Dynacore-dev/PoolGuard/hardware/PoolDosingController/PoolDosingController.png

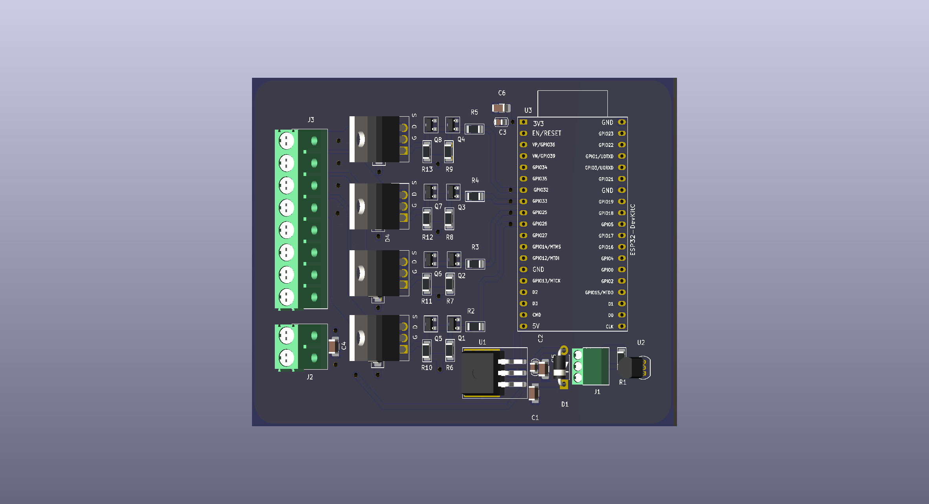
hardware/PoolDosingController/PoolDosingController.png
