Dynacore-dev/PoolGuard/hardware/PoolDosingController/PoolDosingController2.png

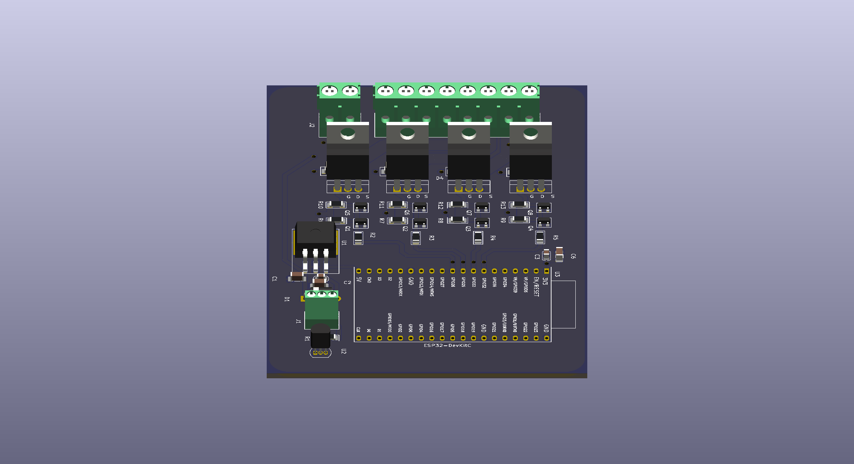
hardware/PoolDosingController/PoolDosingController2.png
