Dynacore-dev/PoolGuard/hardware/PoolDosingController/PoolDosingController-BOM.csv

# | References | Qty | Value | Footprint | MPN | DNP
1 | C1 | 1 | 0.33uF | Capacitor_SMD:C_1206_3216Metric_Pad1.33x1.80mm_HandSolder
2 | C2, C3 | 2 | 0.1uF | PCM_Capacitor_SMD_AKL:C_0805_2012Metric
3 | C4, C5, C6 | 3 | 10uF | Capacitor_SMD:C_1206_3216Metric_Pad1.33x1.80mm_HandSolder
4 | D1 | 1 | 1N4001 | PCM_Diode_THT_AKL:D_DO-41_SOD81_P7.62mm_Horizontal
5 | D2, D3, D4, D5 | 4 | SS16 | Diode_SMD:D_SMA
6 | J1 | 1 | Screw_Terminal_01x03 | TerminalBlock:TerminalBlock_Xinya_XY308-2.54-3P_1x03_P2.54mm_Horizontal
7 | J2 | 1 | Screw_Terminal_2_P5.00mm | TerminalBlock_Phoenix:TerminalBlock_Phoenix_PT-1,5-2-5.0-H_1x02_P5.00mm_Horizontal
8 | J3 | 1 | Screw_Terminal_4_P5.00mm | TerminalBlock_Phoenix:TerminalBlock_Phoenix_PT-1,5-8-5.0-H_1x08_P5.00mm_Horizontal
9 | Q1, Q2, Q3, Q4, Q5, Q6, Q7, Q8 | 8 | MMBT3904 | PCM_Package_TO_SOT_SMD_AKL:SOT-23
10 | Q9, Q10, Q11, Q12 | 4 | IRFZ44N | PCM_Package_TO_SOT_THT_AKL:TO-220-3_Vertical_GDS
11 | R1 | 1 | 2.2K | PCM_Resistor_SMD_AKL:R_1206_3216Metric_Pad1.42x1.75mm_HandSolder
12 | R2, R3, R4, R5 | 4 | 220 | PCM_Resistor_SMD_AKL:R_1206_3216Metric_Pad1.42x1.75mm_HandSolder
13 | R6, R7, R8, R9, R10, R11, R12, R13 | 8 | 10K | PCM_Resistor_SMD_AKL:R_1206_3216Metric_Pad1.42x1.75mm_HandSolder
14 | U1 | 1 | LM7805S | PCM_Package_TO_SOT_SMD_AKL:TO-263-3_TabPin2 | L7805ABD2T-TR
15 | U2 | 1 | DS18S20 | Package_TO_SOT_THT:TO-92_Inline | DS18S20+
16 | U3 | 1 | ESP32-DevKitC | PCM_Espressif:ESP32-DevKitC | ESP32-DEVKITC-32E
