Dynacore-dev/PoolGuard/hardware/Dosieranlage/Dosieranlage.csv

# | Reference | Qty | Value | Footprint | DNP
1 | C1 | 1 | 0,33uF | Capacitor_SMD:C_1206_3216Metric_Pad1.33x1.80mm_HandSolder
2 | C2 | 1 | 0,1uF | Capacitor_SMD:C_0805_2012Metric_Pad1.18x1.45mm_HandSolder
3 | D1 | 1 | 1N4001 | Diode_SMD:D_SOD-123F
4 | D2, D3, D4, D5 | 4 | SS16 | Diode_SMD:D_SMA_Handsoldering
5 | J1 | 1 | JST_05 | Connector_JST:JST_EH_B5B-EH-A_1x05_P2.50mm_Vertical
6 | J2 | 1 | Screw_Terminal_01x03 | TerminalBlock:TerminalBlock_Xinya_XY308-2.54-3P_1x03_P2.54mm_Horizontal
7 | J3 | 1 | PINHD_1x6_Male | Connector_PinHeader_2.54mm:PinHeader_1x06_P2.54mm_Vertical
8 | J4 | 1 | PINHD_1x19_Female | Connector_PinSocket_2.54mm:PinSocket_1x19_P2.54mm_Vertical
9 | J5 | 1 | Screw_Terminal_2_P5.00mm | TerminalBlock_Phoenix:TerminalBlock_Phoenix_PT-1,5-2-5.0-H_1x02_P5.00mm_Horizontal
10 | J6 | 1 | Screw_Terminal_4_P5.00mm | TerminalBlock_Phoenix:TerminalBlock_Phoenix_PT-1,5-8-5.0-H_1x08_P5.00mm_Horizontal
11 | Q1, Q2, Q3, Q4, Q5, Q6, Q7, Q8 | 8 | MMBT3904 | PCM_Package_TO_SOT_SMD_AKL:SOT-23_Handsoldering
12 | Q9, Q10, Q11, Q12 | 4 | IRFZ44N | PCM_Package_TO_SOT_THT_AKL:TO-220-3_Vertical_GDS
13 | R1, R2, R3, R4, R10, R11, R12, R13, R14, R15, R16, R17 | 12 | 10K | PCM_Resistor_SMD_AKL:R_1206_3216Metric_Pad1.42x1.75mm_HandSolder
14 | R5 | 1 | 2.2K | PCM_Resistor_SMD_AKL:R_1206_3216Metric_Pad1.42x1.75mm_HandSolder
15 | R6, R7, R8, R9 | 4 | 220 | PCM_Resistor_SMD_AKL:R_1206_3216Metric_Pad1.42x1.75mm_HandSolder
16 | U1 | 1 | LM7805S | PCM_Package_TO_SOT_SMD_AKL:TO-263-3_TabPin2
17 | U2 | 1 | DS18S20 | Package_TO_SOT_THT:TO-92_Inline
18 | U3 | 1 | ESP32-DevKitC | PCM_Espressif:ESP32-DevKitC
