Dynacore-dev/PoolGuard/hardware/PoolDosingController/PoolDosingController.kicad_pcb

## KiCad design hardware/PoolDosingController/PoolDosingController.kicad_pcb (2026-11-10)

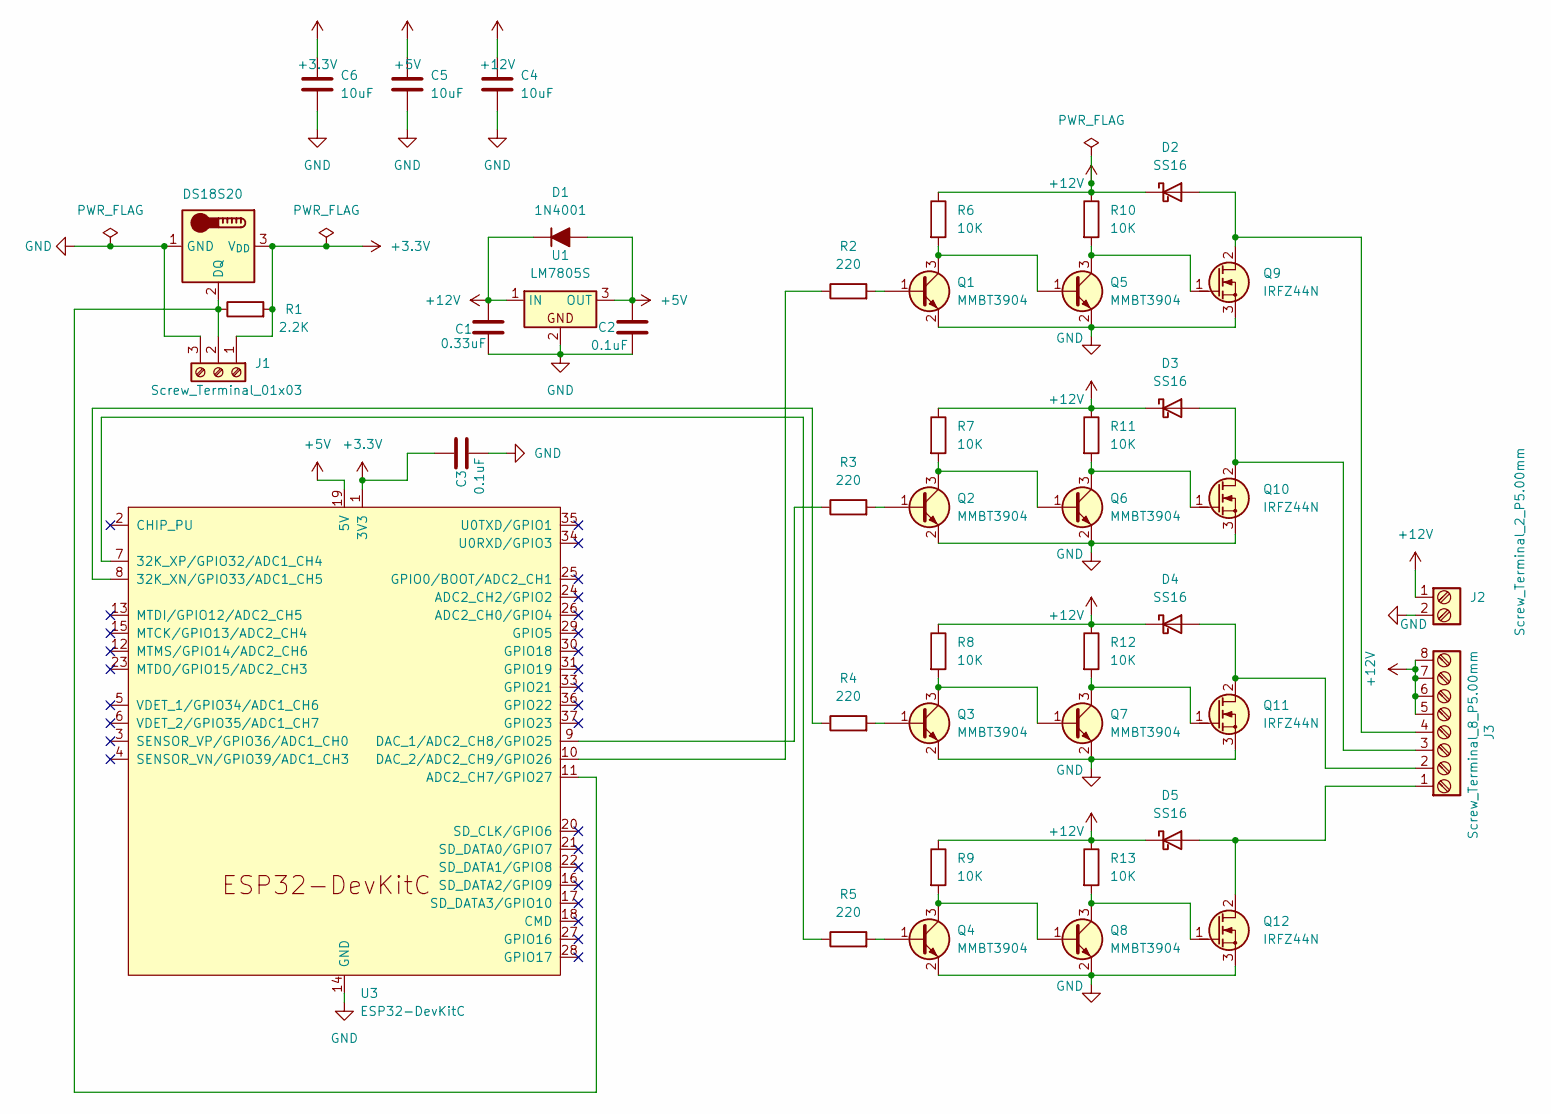
[picture p3: schematic PoolDosingController.kicad_sch]

Parts:
C1: 0.33uF; C_1206_3216Metric_Pad1.33x1.80mm_HandSolder
C2, C3: 0.1uF; C_0805_2012Metric; LCSC_Alt_0402 C1525 (Samsung CL05B104KO5NNNC, 0402, 1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
C4, C5, C6: 10uF; C_1206_3216Metric_Pad1.33x1.80mm_HandSolder
D1: 1N4001; D_DO-41_SOD81_P7.62mm_Horizontal
D2, D3, D4, D5: SS16; D_SMA
J1: Screw_Terminal_01x03; TerminalBlock_Xinya_XY308-2.54-3P_1x03_P2.54mm_Horizontal
J2: Screw_Terminal_2_P5.00mm; TerminalBlock_Phoenix_PT-1,5-2-5.0-H_1x02_P5.00mm_Horizontal
J3: Screw_Terminal_8_P5.00mm; TerminalBlock_Phoenix_PT-1,5-8-5.0-H_1x08_P5.00mm_Horizontal
Q1, Q2, Q3, Q4, Q5, Q6, Q7, Q8: MMBT3904; SOT-23
Q9, Q10, Q11, Q12: IRFZ44N; TO-220-3_Vertical_GDS
R1: 2.2K; R_1206_3216Metric_Pad1.42x1.75mm_HandSolder
R2, R3, R4, R5: 220; R_1206_3216Metric_Pad1.42x1.75mm_HandSolder
R6, R7, R8, R9, R10, R11, R12, R13: 10K; R_1206_3216Metric_Pad1.42x1.75mm_HandSolder
U1: LM7805S; TO-263-3_TabPin2; MPN L7805ABD2T-TR
U2: DS18S20; TO-92_Inline; MPN DS18S20+
U3: ESP32-DevKitC; MPN ESP32-DEVKITC-32E

Connections:
+3.3V: C3.1, C6.1, J1.1, R1.2, U2.3 (V_{DD}), U3.1 (3V3)
+5V: C2.1, C5.1, D1.2 (A), U1.3 (OUT), U3.19 (5V)
+12V: C1.1, C4.1, D1.1 (K), D2.1 (K), D3.1 (K), D4.1 (K), D5.1 (K), J2.1, J3.5, J3.6, J3.7, J3.8, R6.1, R7.1, R8.1, R9.1, R10.1, R11.1, R12.1, R13.1, U1.1 (IN)
GND: C1.2, C2.2, C3.2, C4.2, C5.2, C6.2, J1.3, J2.2, Q1.2 (E), Q2.2 (E), Q3.2 (E), Q4.2 (E), Q5.2 (E), Q6.2 (E), Q7.2 (E), Q8.2 (E), Q9.3 (S), Q10.3 (S), Q11.3 (S), Q12.3 (S), U1.2, U2.1 (GND), U3.14 (GND), U3.32 (GND), U3.38 (GND)
unnamed: D2.2 (A), J3.4, Q9.2 (D)
unnamed: D3.2 (A), J3.3, Q10.2 (D)
unnamed: D4.2 (A), J3.2, Q11.2 (D)
unnamed: D5.2 (A), J3.1, Q12.2 (D)
unnamed: J1.2, R1.1, U2.2 (DQ), U3.11 (ADC2_CH7/GPIO27)
unnamed: Q1.1 (B), R2.2
unnamed: Q1.3 (C), Q5.1 (B), R6.2
unnamed: Q2.1 (B), R3.2
unnamed: Q2.3 (C), Q6.1 (B), R7.2
unnamed: Q3.1 (B), R4.2
unnamed: Q3.3 (C), Q7.1 (B), R8.2
unnamed: Q4.1 (B), R5.2
unnamed: Q4.3 (C), Q8.1 (B), R9.2
unnamed: Q5.3 (C), Q9.1 (G), R10.2
unnamed: Q6.3 (C), Q10.1 (G), R11.2
unnamed: Q7.3 (C), Q11.1 (G), R12.2
unnamed: Q8.3 (C), Q12.1 (G), R13.2
unnamed: R4.1, U3.8 (32K_XN/GPIO33/ADC1_CH5)
unnamed: R5.1, U3.7 (32K_XP/GPIO32/ADC1_CH4)
unnamed: R3.1, U3.9 (DAC_1/ADC2_CH8/GPIO25)
unnamed: R2.1, U3.10 (DAC_2/ADC2_CH9/GPIO26)

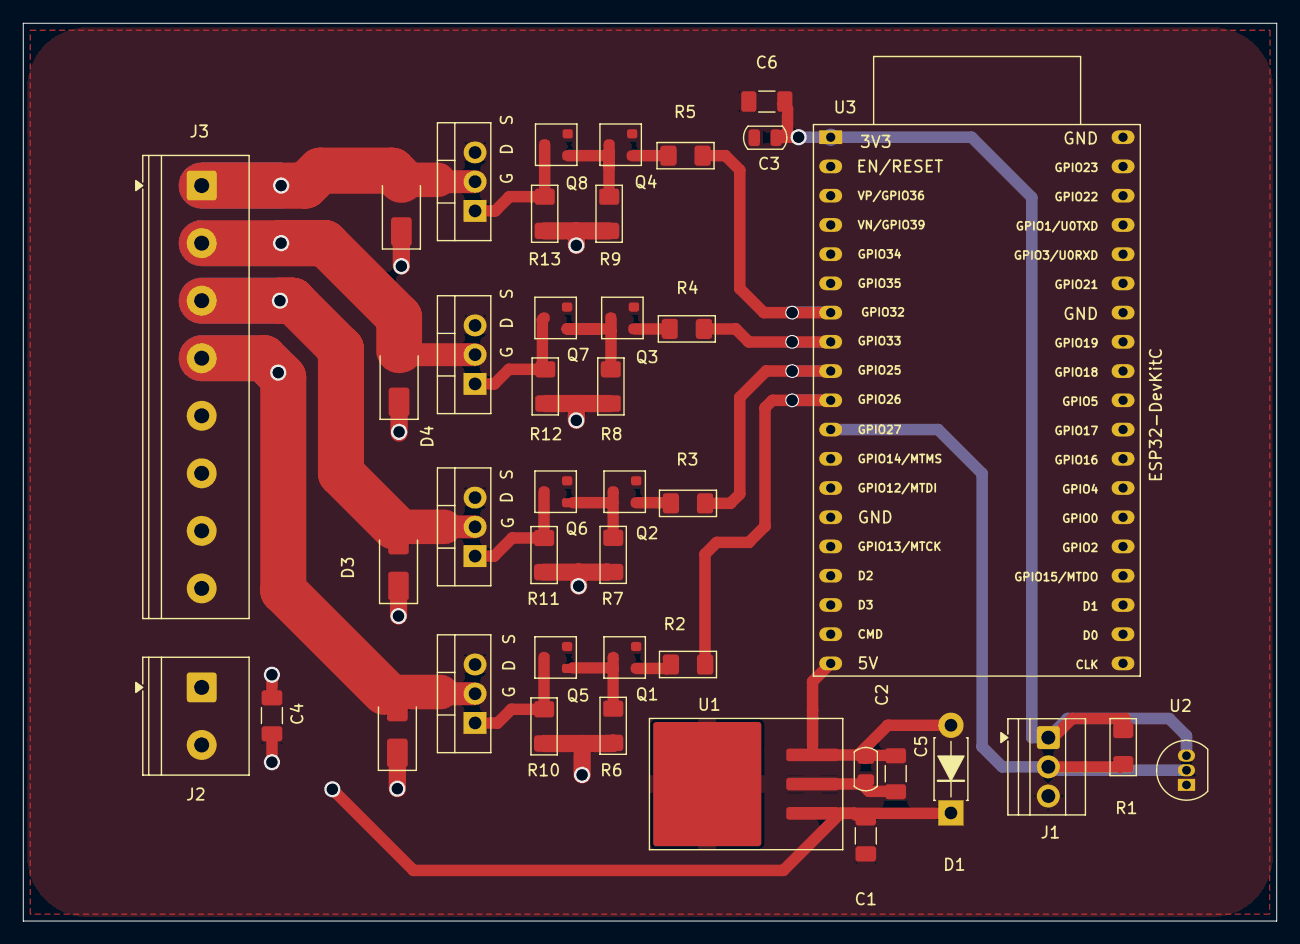
[picture p4: board PoolDosingController.kicad_pcb from above]

Board: 2 copper layers, 108.9 x 78.0 mm, 42 parts (0 on the bottom side), 25 nets.
