Dynacore-dev/PoolGuard/include/DS18B20.hpp

#ifndef DS18B20_HPP
#define DS18B20_HPP

#include <Arduino.h>
#include <OneWire.h>
#include <DallasTemperature.h>
#include "Config.h"

class DS18B20 {
  public:
    DS18B20(int pin);
    void begin();
    void update(); // processes measurements in the background
    
    float getLatestTemperature() { return _lastTemp; }
    bool isConnected() { return _sensorOk; }
    void printAddress(DeviceAddress deviceAddress);
    void printTemperature(DeviceAddress deviceAddress);
    void printResolution(DeviceAddress deviceAddress);

  private:
    OneWire _oneWire;
    DallasTemperature _sensors;
    float _lastTemp = -127.0;
    bool _sensorOk = false;  // becomes true once a valid reading arrives
    unsigned long _lastMillis = 0;
    const unsigned long _interval = Config::TEMP_SENSOR_INTERVAL_MS;
};

#endif
