Dynacore-dev/PoolGuard/(commit log)

2026-08-26 Initial commit: Poolsteuerung ESP32-Projekt
    Enthält lib_deps-Fix (OneWire, DallasTemperature, AsyncTCP,
    ESPAsyncWebServer), korrigierte TimeRange-Initialisierung für
    _ph/_cl sowie die umschaltbare Dosiermenge (DOSE_0125L/025L/05L).
    [DS18B20.cpp, DS18B20.hpp, PoolTime.cpp, PoolTime.hpp, Poolsteuerung.ino, ServerManager.cpp, ServerManager.hpp, WifiManager.cpp]
2026-08-26 Config.h einführen: Pins, WLAN, NTP/Zeit, Zeitpläne und Dosiermenge zentralisiert
    Alle bisherigen Magic Numbers (Pins, WLAN-Zugangsdaten, NTP-Server/
    Zeitzone, Pumpen-Zeitfenster, Dosierdauer, WLAN-Reconnect-Verhalten,
    Loop-Delay, Sensor-Messintervall) sind jetzt in src/Config.h
    gebündelt statt über mehrere .hpp/.cpp-Dateien verstreut.
2026-08-26 Drei kleine Bugfixes: Pointer-Arithmetik, fehlendes Sensor-Update, toter Code
    - Poolsteuerung.ino: "const char* + int" war Zeiger-Arithmetik statt
    String-Verkettung (undefiniertes Verhalten je nach connectionCount)
    - ServerManager.cpp: tempSensor.update() wurde nie aufgerufen, die
    Wassertemperatur im Web-UI blieb dauerhaft beim Initialwert -127.0
    - WifiManager.hpp/.cpp: nie implementierte availableClient()-Deklaration
    und zugehörige tote _server-Referenzen entfernt
    [Poolsteuerung.ino, ServerManager.cpp, WifiManager.cpp, WifiManager.hpp]
2026-08-26 Toten Code entfernen: PoolPumpTime, updateDevice(), wifi_disconnect(), .active-CSS
    - PoolTime.hpp: PoolPumpTime-Klasse war nur deklariert, nie implementiert
    oder instanziiert
    - ServerManager.hpp: updateDevice(Device&) nie implementiert/aufgerufen
    (gleicher Fallstrick wie das zuvor entfernte availableClient())
    - WifiManager.cpp: wifi_disconnect() implementiert, aber nirgends
    deklariert oder aufgerufen
    - ServerManager.cpp: CSS-Klasse .active wurde nie einem Element zugewiesen
    Die DS18B20-Debug-Print-Methoden bleiben bewusst erhalten.
2026-08-26 CLAUDE.md hinzufügen
    Dokumentiert Build-Befehle sowie die Architektur (Config.h als
    zentrale Konfiguration, ServerManager mit Sicherheits-Interlock,
    WifiManager, PoolTime, DS18B20) für zukünftige Claude-Code-Sessions.
2026-08-26 Config.h aus dem Repo nehmen, Config.example.h als Vorlage hinzufügen
    Config.h enthält die echten WLAN-Zugangsdaten und wird jetzt per
    .gitignore ausgeschlossen (bleibt lokal unverändert bestehen).
    Config.example.h ist die versionierte Vorlage mit Platzhaltern statt
    echter Zugangsdaten - zum Einrichten kopieren und anpassen.
2026-08-26 Projekt in PoolGuard umbenennen
    - Poolsteuerung.ino -> PoolGuard.ino
    - Startup-Meldung und Web-Dashboard-Titel angepasst
    - platformio.ini: [platformio] name = PoolGuard + Kopfkommentar
    - CLAUDE.md: Referenzen aktualisiert
2026-08-26 Dashboard-Sprache konfigurierbar machen (DE/EN)
    Config::DASHBOARD_LANGUAGE (Language::DE/EN) steuert alle sichtbaren
    Dashboard-Texte in ServerManager.cpp (Status/Modus, Pumpen-Labels,
    Intervall-/Laufzeit-Anzeige, Dosierlabel inkl. Dezimaltrennzeichen).
    Standard bleibt Deutsch.
2026-08-26 Uninitialisierte Member und zwei Logikfehler beheben
    - ServerManager-Konstruktor initialisiert jetzt _timeSync und
    isPoolpumpActiv (Clang-Tidy: "Constructor does not initialize
    these fields").
    - isPoolpumpActiv wurde in der Pool-Intervall-Schleife pro Intervall
    neu gesetzt und konnte dadurch trotz laufender Pumpe auf false
    landen (Temperaturanzeige blieb dann versteckt). Wird jetzt einmalig
    aus poolShouldRun übernommen.
    - Doppelten, unbedingten rtcClock.begin()-Aufruf in PoolGuard.ino
    entfernt (NTP-Sync wurde beim Start zweimal angestoßen).
2026-08-26 HTTP Basic Auth für Dashboard/Steuer-Endpunkte einführen
    Sicherheitsproblem: /set?dev=<pool|ph|cl>&m=<0|1|2> war ohne
    Authentifizierung erreichbar, sodass jeder im gleichen Netz die
    Dosierpumpen dauerhaft einschalten konnte (auch per CSRF, z.B. über
    ein <img>-Tag). Alle drei Routen (/, /set, /status) prüfen jetzt
    per requireAuth() HTTP Basic Auth gegen Config::WEB_AUTH_USER/
    WEB_AUTH_PASSWORD.
    Zusätzlich: der m-Parameter in /set wird jetzt auf den gültigen
    DeviceMode-Bereich (0-2) geprüft, statt ungeprüft gecastet zu werden.
    CLAUDE.md entsprechend ergänzt.
2026-08-26 Dashboard-Auth per Config::WEB_AUTH_ENABLED abschaltbar machen
    Standardmäßig aus, da das Netzwerk als vertrauenswürdig gilt und
    niemand mit Netzwerkzugang die Steuerung missbrauchen würde. Code
    und Config-Felder bleiben bestehen, damit die Basic Auth bei Bedarf
    jederzeit ohne Codeänderung wieder aktiviert werden kann.
2026-08-26 Watchdog, OTA-Updates und Sensor-Fehleranzeige hinzufügen
    - Task-Watchdog (Config::WATCHDOG_TIMEOUT_SEC, Panic-Reboot bei
    Timeout) abgesichert gegen Hänger in loop(); Timeout liegt bewusst
    über der maximalen WLAN-Reconnect-Blockierzeit.
    - ArduinoOTA (Config::OTA_ENABLED, passwortgeschützt via
    Config::OTA_PASSWORD) für Firmware-Updates ohne USB-Kabel.
    - DS18B20::isConnected() meldet, ob der letzte Messwert gültig war;
    das Dashboard zeigt bei Sensorfehler jetzt eine rote Fehlermeldung
    statt eines veralteten/ungültigen Temperaturwerts.
    [Config.example.h, DS18B20.cpp, DS18B20.hpp, PoolGuard.ino, ServerManager.cpp]
2026-08-26 Konfigurationsdateien für Projektencoding und VCS-Einstellungen hinzufügen
2026-08-27 Vendor Arduino libraries into lib/ for offline builds
    Bibliotheken werden nicht mehr per lib_deps aus der PlatformIO-Registry
    geladen, sondern liegen fertig unter lib/, damit das Projekt auch ohne
    Internetzugriff baut (z. B. auf einem Schul-Laptop). ESPAsyncWebServer's
    library.json wurde auf die espressif32-Abhängigkeit (AsyncTCP) getrimmt,
    da PlatformIOs Dependency Finder sonst versucht, plattformfremde
    Abhängigkeiten (RPAsyncTCP) nachzuladen.
    Zusätzlich zwei Skripte:
    - scripts/update-libs.sh lädt neue Versionen und aktualisiert lib/
    - scripts/check_lib_updates.py läuft als PlatformIO pre-Build-Hook und
    warnt (nicht blockierend, rate-limited) wenn neuere Versionen verfügbar
    sind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
2026-08-27 Document vendored libraries and helper scripts in README
    Update the Dependencies section to reflect that libraries live in lib/
    instead of lib_deps, and add a Scripts section covering update-libs.sh,
    check_lib_updates.py, and list-boards.sh.
    Also add .claude/settings.json to disable the Claude co-author trailer
    on commits/PRs for this project.
2026-08-27 Fix critical/high security review findings
    - PoolGuard.ino: always initialize server/pins/time-sync/OTA in setup(),
    regardless of the initial WiFi connection attempt. Previously a WiFi
    outage at boot left _timeSync null, causing handleLogic() to
    null-dereference on every loop() call (crash-reboot loop), and
    permanently skipped starting the dashboard/OTA even after WiFi
    reconnected.
    - ServerManager.cpp: /set (state-changing) is now POST-only and checks
    the Origin header against the device's own Host, closing the CSRF gap
    that let any page/image tag on the LAN trigger pump/dosing changes.
    - PoolTime.cpp: bound getLocalTime() calls to a 5ms timeout instead of
    the 5000ms default,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
    [PoolGuard.ino, PoolTime.cpp, ServerManager.cpp]
2026-08-27 Fix medium-severity security review findings
    - DS18B20.cpp: request the first conversion and start the interval timer
    in begin() instead of update(), so the first temperature read happens
    after a real conversion completes instead of returning the sensor's
    85.00C power-on default as if it were a valid reading.
    - ServerManager.cpp: isInside()'s duration-based window (pH/chlorine
    dosing) now handles windows that cross midnight instead of silently
    truncating or skipping them.
    - check_lib_updates.py: bound the registry response read by both a total
    wall-clock deadline and a maximum size, since urlopen's timeout only
    bounds individual socket operations and json.load had no size cap.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
    [DS18B20.cpp, ServerManager.cpp]
2026-08-27 Fix low-severity security review findings
    - CLAUDE.md: correct the stale claim that libraries use lib_deps; they're
    vendored under lib/ (matches README.md and the actual platformio.ini).
    - update-libs.sh: add nullglob so an empty pio pkg install doesn't iterate
    the loop with a literal unexpanded glob string, plus an explicit count
    check that fails with a clear message instead of a confusing 'cp:
    cannot stat' error.
    - Config.example.h / README.md: document that the dashboard has no TLS,
    so Basic Auth credentials travel unencrypted - only enable
    WEB_AUTH_ENABLED on a trusted network. (A real fix would mean adding
    TLS support, out of scope for this vendored-library-dependent, low-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
    [Config.example.h]
2026-08-27 Fix info-severity security review findings
    - PoolTime.cpp: getFormattedTime()'s NTP-not-synced fallback now respects
    Config::DASHBOARD_LANGUAGE instead of always returning the hardcoded
    German string.
    - ServerManager.cpp / CLAUDE.md / README.md: correct the safety-interlock
    description - it reads back the ESP32's own GPIO output register, not
    an actual flow sensor or relay feedback signal, so a relay/motor
    failure that leaves the pin driven HIGH wouldn't be caught. No hardware
    exists to fix this in code; the docs previously overstated the
    guarantee.
    [PoolTime.cpp, ServerManager.cpp]
2026-08-28 Add OTA upload environment for PlatformIO
    Adds esp32dev_ota, which uploads over WiFi via espota instead of USB.
    The OTA password is pulled from the OTA_PASSWORD env var at upload
    time so it never ends up in the tracked ini file.
2026-08-28 Add step-by-step install guide for Windows/macOS/Linux to README
    Covers PlatformIO Core install via pipx, USB driver setup, cloning,
    building, USB and OTA upload, and the ModemManager/serial-port
    conflict on Linux found while setting up OTA. Also documents the new
    esp32dev_ota upload command in the Commands table.
2026-08-28 Add mutual exclusion interlock between pH and chlorine pumps
    Mixing undiluted pH and chlorine dosing chemicals can be hazardous, so
    the two pumps can no longer run at the same time in any mode
    combination, including both set to manual ON. pH takes priority.
    Toggle via the new Config::CHEM_PUMP_INTERLOCK_ENABLED (default true).
    [Config.example.h, ServerManager.cpp]
2026-08-28 Fix water temperature not showing on the dashboard
    The temperature <div> was only emitted into the page when the pool
    pump happened to be running at page-load time, and it was never
    refreshed afterwards. It's now always rendered and updated live via
    /status every second, same as the pump state/mode fields.
    [ServerManager.cpp]
2026-08-29 Retry ArduinoOTA/mDNS startup once WiFi actually connects
    ArduinoOTA.begin() also registers the mDNS responder for
    WIFI_HOSTNAME.local, but was only ever called once in setup(),
    right after the initial WiFi connect attempt. If WiFi wasn't up
    yet at that point (e.g. router still rebooting after a power
    outage), OTA and poolguard.local stayed dead for the rest of the
    uptime even though WiFi reconnected fine afterward in loop().
    Claude-Session: https://claude.ai/code/session_01FL3hV7QwvHB94Nrt6yscF9
2026-09-13 Add Dosieranlage KiCad hardware design under hardware/
    PCB/schematic fuer den ESP32-Pooldosierer, der von dieser Firmware
    angesteuert wird: 0 DRC-Fehler, dedizierte Power-Netzklassen und eine
    vollstaendige projektlokale Bibliothek (Symbole, Footprints, 3D-Modelle)
    fuer portables Klonen.
    Claude-Session: https://claude.ai/code/session_013o7XFg7ivFRWMEKNzovhoe
2026-09-13 Rename hardware project to English, refresh BOM and docs
    Dosieranlage -> PoolDosingController (files, netclass names, and
    comma-decimal component values translated to English). Replaces the
    stale BOM CSV (from the original pre-redesign board) with an accurate
    one generated from the current schematic, and adds a hardware README
    covering the board's channels, connectors, netclasses, BOM, and DRC
    status, linked from the top-level README.
    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
2026-09-13 Add PCB screenshots and PCBWay production export
    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
